omskcity/RF-transmitter/HW/RFMODEM-STACIONAR.xls

Revised: Friday, July 27, 2012
Revision: 1
Bill Of Materials July 27,2012 11:47:47 | Page1
Item | Quantity | Reference | Part
______________________________________________
1 | 2 | C1,C2 | 12pF NP0 0603 | Конденсатор SMD | Конденсатор SMD 12pF NP0 0603
2 | 12 | C3,C4,C6,C7,C8,C9,C10, | 0.1uF X7R 0603 | Конденсатор SMD | Конденсатор SMD 0.1uF X7R 0603
 |  | C11,C12,C13,C14,C23
3 | 2 | C20,C5 | 4.7uF 6.3V SMA | Конденсатор SMD | Конденсатор SMD 4.7uF 6.3V SMA
4 | 1 | C15 | 220pF NP0 0603 | Конденсатор SMD | Конденсатор SMD 220pF NP0 0603
5 | 1 | C16 | 0.01uF X7R 0603 | Конденсатор SMD | Конденсатор SMD 0.01uF X7R 0603
6 | 1 | C17 | 2.7pF NP0 0603 | Конденсатор SMD | Конденсатор SMD 2.7pF NP0 0603
7 | 1 | C18 | 68pF NP0 0603 | Конденсатор SMD | Конденсатор SMD 68pF NP0 0603
8 | 1 | C19 | 5.1pF NP0 0603 | Конденсатор SMD | Конденсатор SMD 5.1pF NP0 0603
9 | 1 | C21 | 1uF X7R 0603 | Конденсатор SMD | Конденсатор SMD 1uF X7R 0603
10 | 1 | DD1 | STM32F100CBT LQFP-48 | Микросхема | Микросхема STM32F100CBT LQFP-48
11 | 1 | D1 | BAT54C SOT23 | Диод | Диод BAT54C SOT23
12 | 1 | D2 | KPT-1608EC | Светодиод | Светодиод KPT-1608EC
13 | 1 | D3 | BZX84C15 SOT23 | Стабилитрон | Стабилитрон BZX84C15 SOT23
14 | 1 | D4 | KPT-1608SGC | Светодиод | Светодиод KPT-1608SGC
15 | 1 | JP1 | PLS-3 | Разъем | Разъем PLS-3
18 | 1 | L1 | LQW18ANR39J00D | Индуктивность | Индуктивность LQW18ANR39J00D
19 | 1 | L2 | MLG1608B33NJ | Индуктивность | Индуктивность MLG1608B33NJ
20 | 1 | L3 | MLG1608B47NJ | Индуктивность | Индуктивность MLG1608B47NJ
21 | 4 | R1,R2,R3,R4 | 100 5% 0603 | Резистор SMD | Резистор SMD 100 5% 0603
22 | 2 | R5,R6 | 0 5% 0603 | Резистор SMD | Резистор SMD 0 5% 0603
23 | 2 | R7,R9 | 1K 5% 0603 | Резистор SMD | Резистор SMD 1K 5% 0603
24 | 1 | U1 | MAX3222EEUP+ TSSOP20 | Микросхема | Микросхема MAX3222EEUP+ TSSOP20
25 | 1 | U2 | MRF49XA | Микросхема | Микросхема MRF49XA
26 | 1 | U5 | LT1117-3.3 SOT223 | Микросхема | Микросхема LT1117-3.3 SOT223
27 | 1 | X1 | 10MHz HC-49U/SM | Кв.резонатор SMD | Кв.резонатор SMD 10MHz HC-49U/SM
28 | 1 | Y1 | 8MHz HC-49U/SM | Кв.резонатор SMD | Кв.резонатор SMD 8MHz HC-49U/SM
