omskcity/RF-transmitter/HW/rfmodem-stacionar.dxf

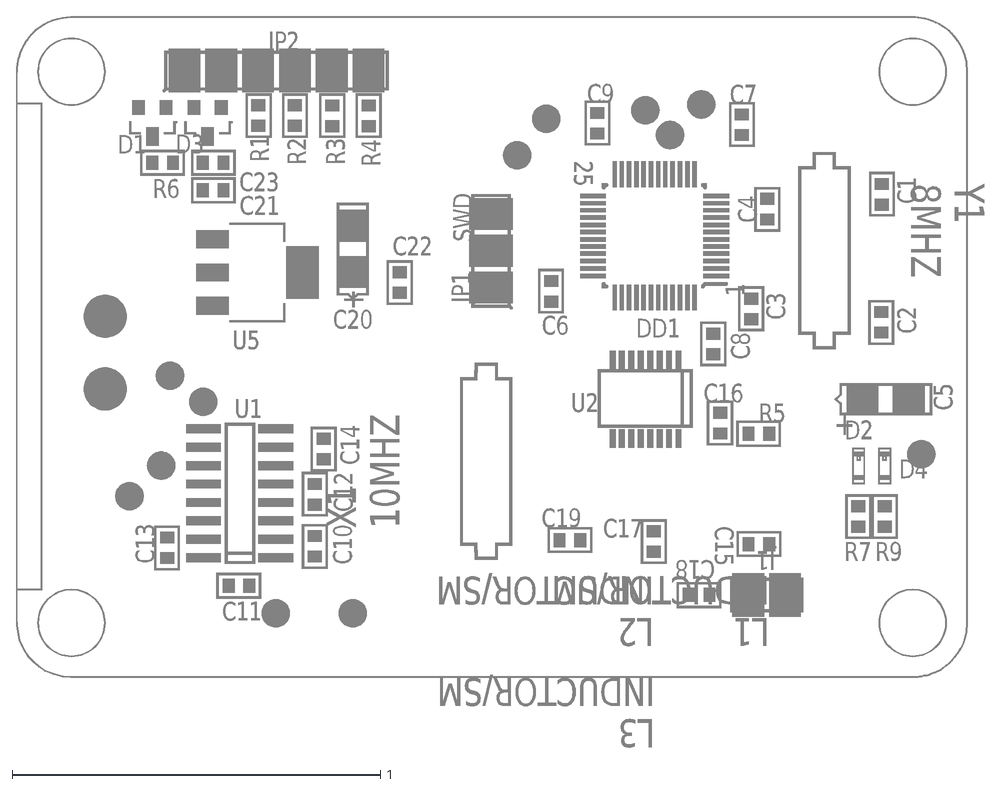
[picture p1: CAD file, 2012-10-08]
HW/rfmodem-stacionar.dxf
U2
INDUCTOR/SM
L3
C13
R9
C2
C23
C8
Y1
8MHZ
R6
C4
C9
C3
C5
+
C10
C21
JP2
U1
D2
DD1
25
1
C22
D1
R2
C20
C17
R3
R7
C18
C12
SWD
JP1
U5
R4
C19
J1
R5
C15
D3
C11
C6
C1
C14
C16
D4
R1
C7
L2
L1
X1
10MHZ
