omskcity/RF-transmitter/HW/Remote Top.pdf

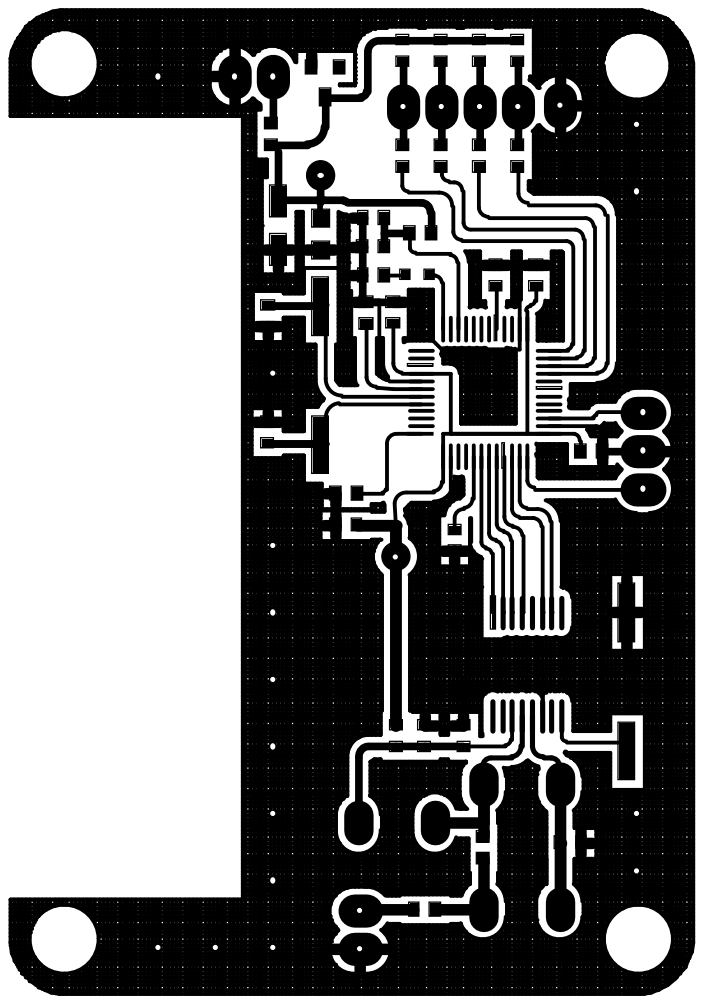
[picture p2: page 1]
