omskcity/RF-transmitter/HW/RFMODEM-STACIONAR-BOT.pdf

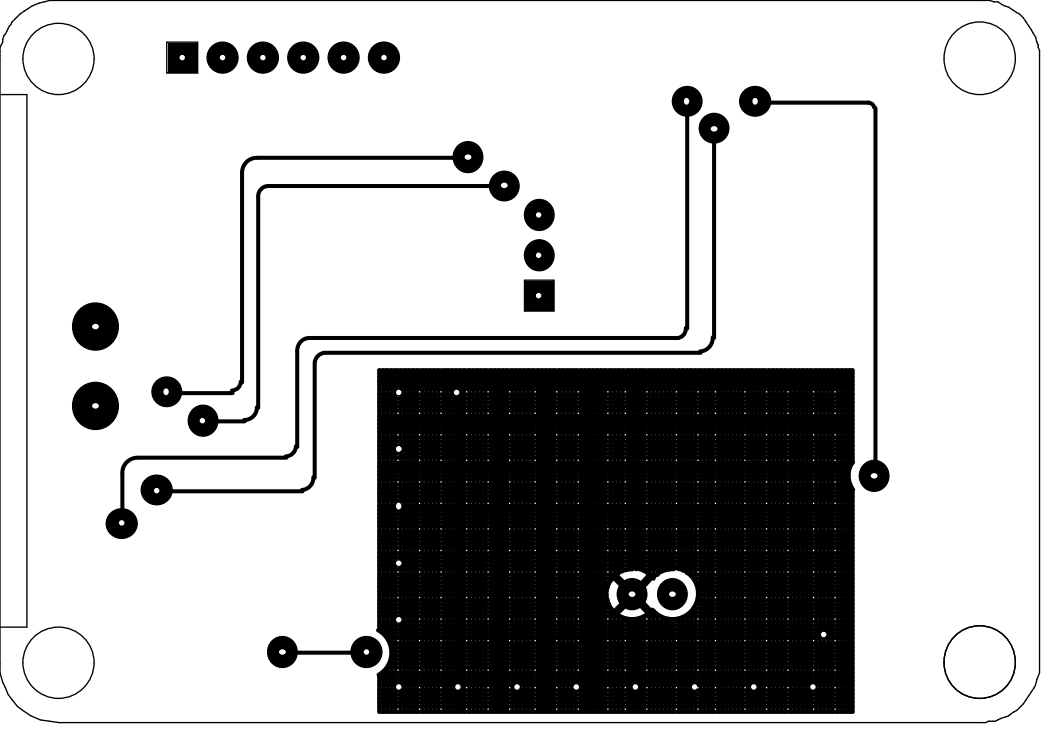
[picture p3: page 1]
