omskcity/RF-transmitter/HW/RFMODEM-STACIONAR-TOP.pdf

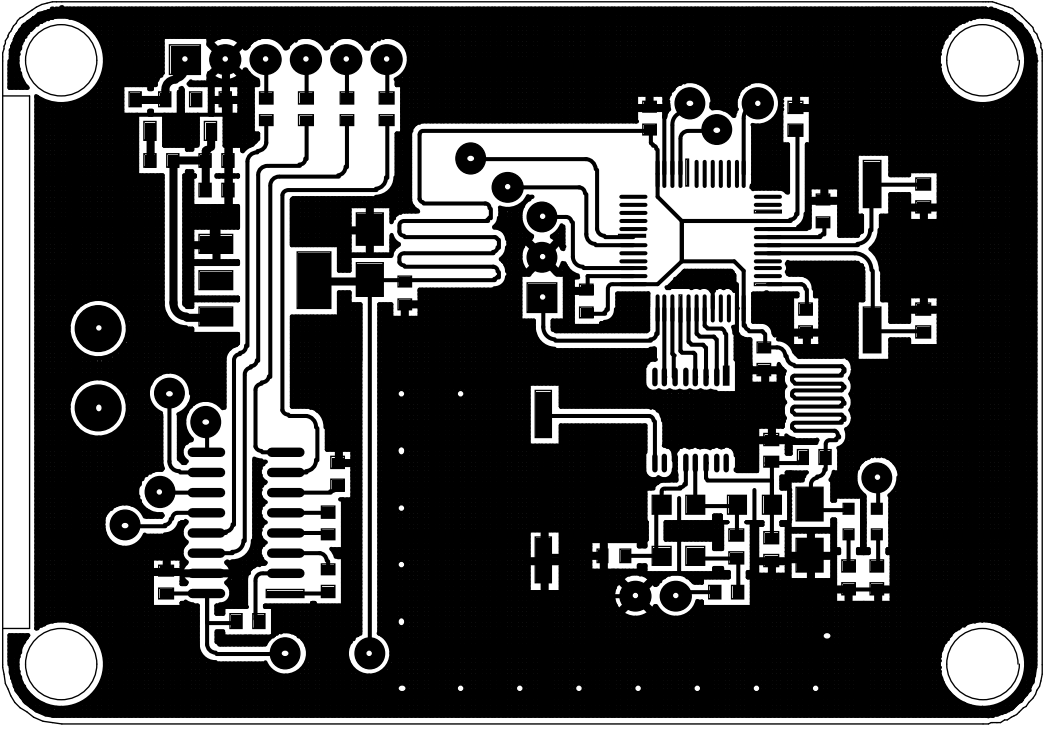
[picture p4: page 1]
