omskcity/RF-transmitter/HW/stacionar-cpu.pdf

# SWD 123

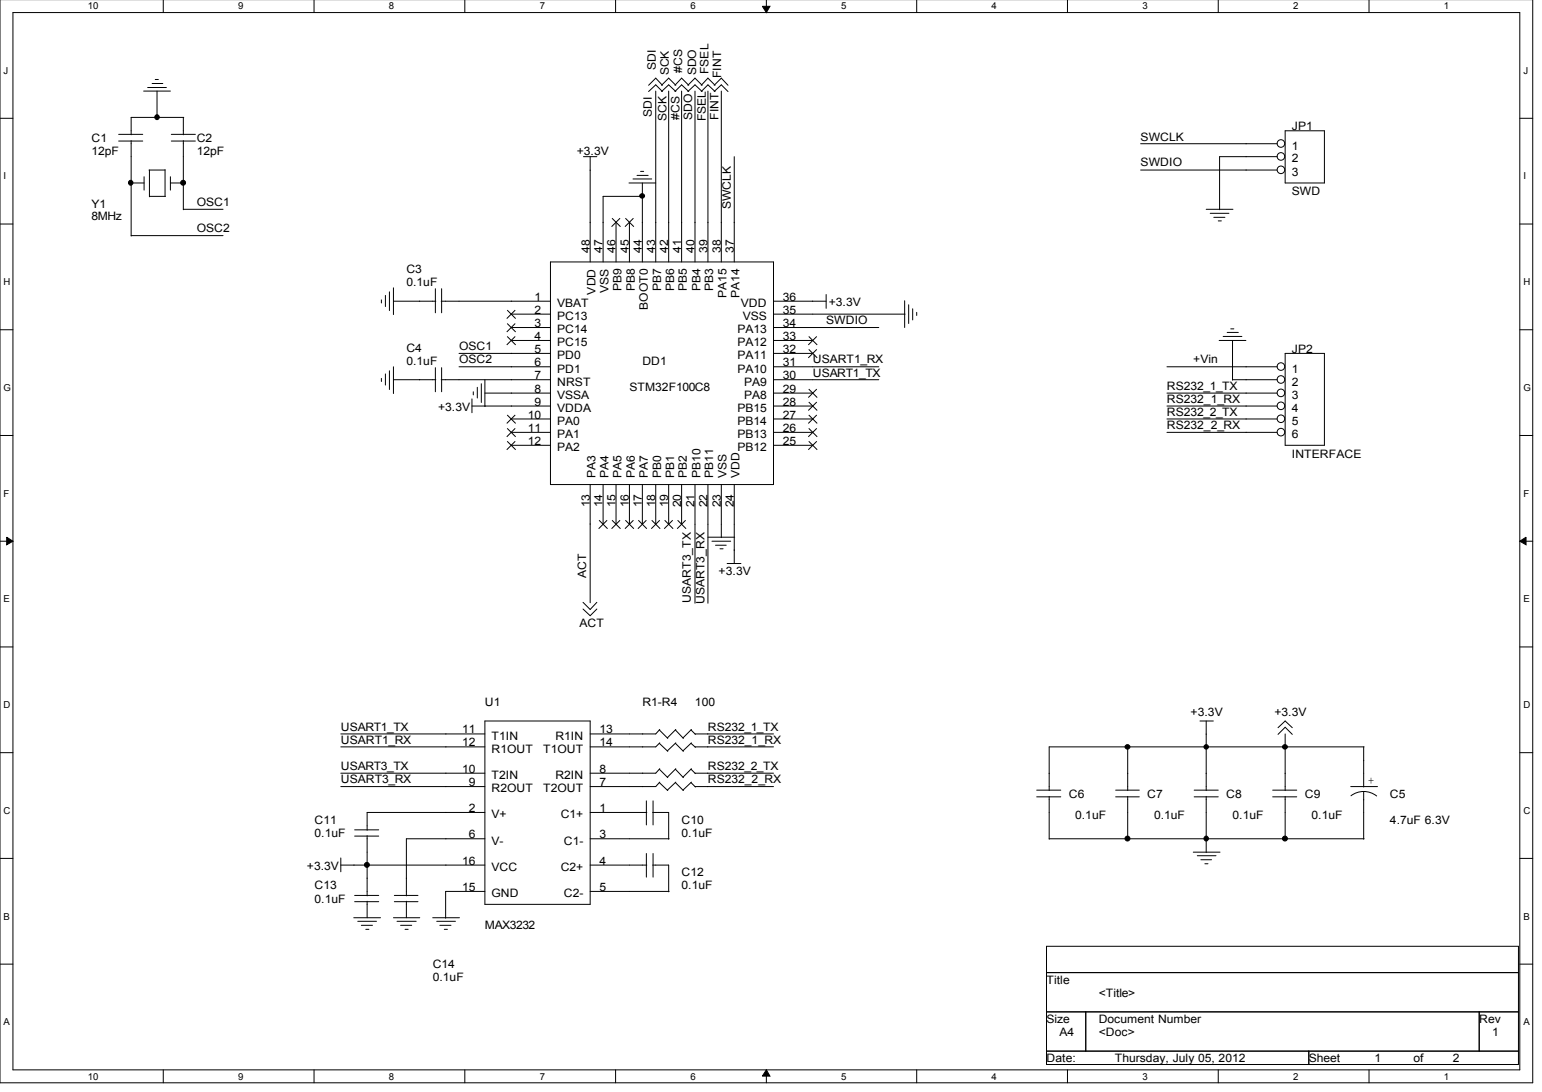
[picture p5: page 1]

Size A4 | Document Number <Doc> | Rev 1

Date: Thursday, July 05, 2012 | Sheet 1 of 2
