omskcity/RF-transmitter/HW/stacionar-rf.pdf

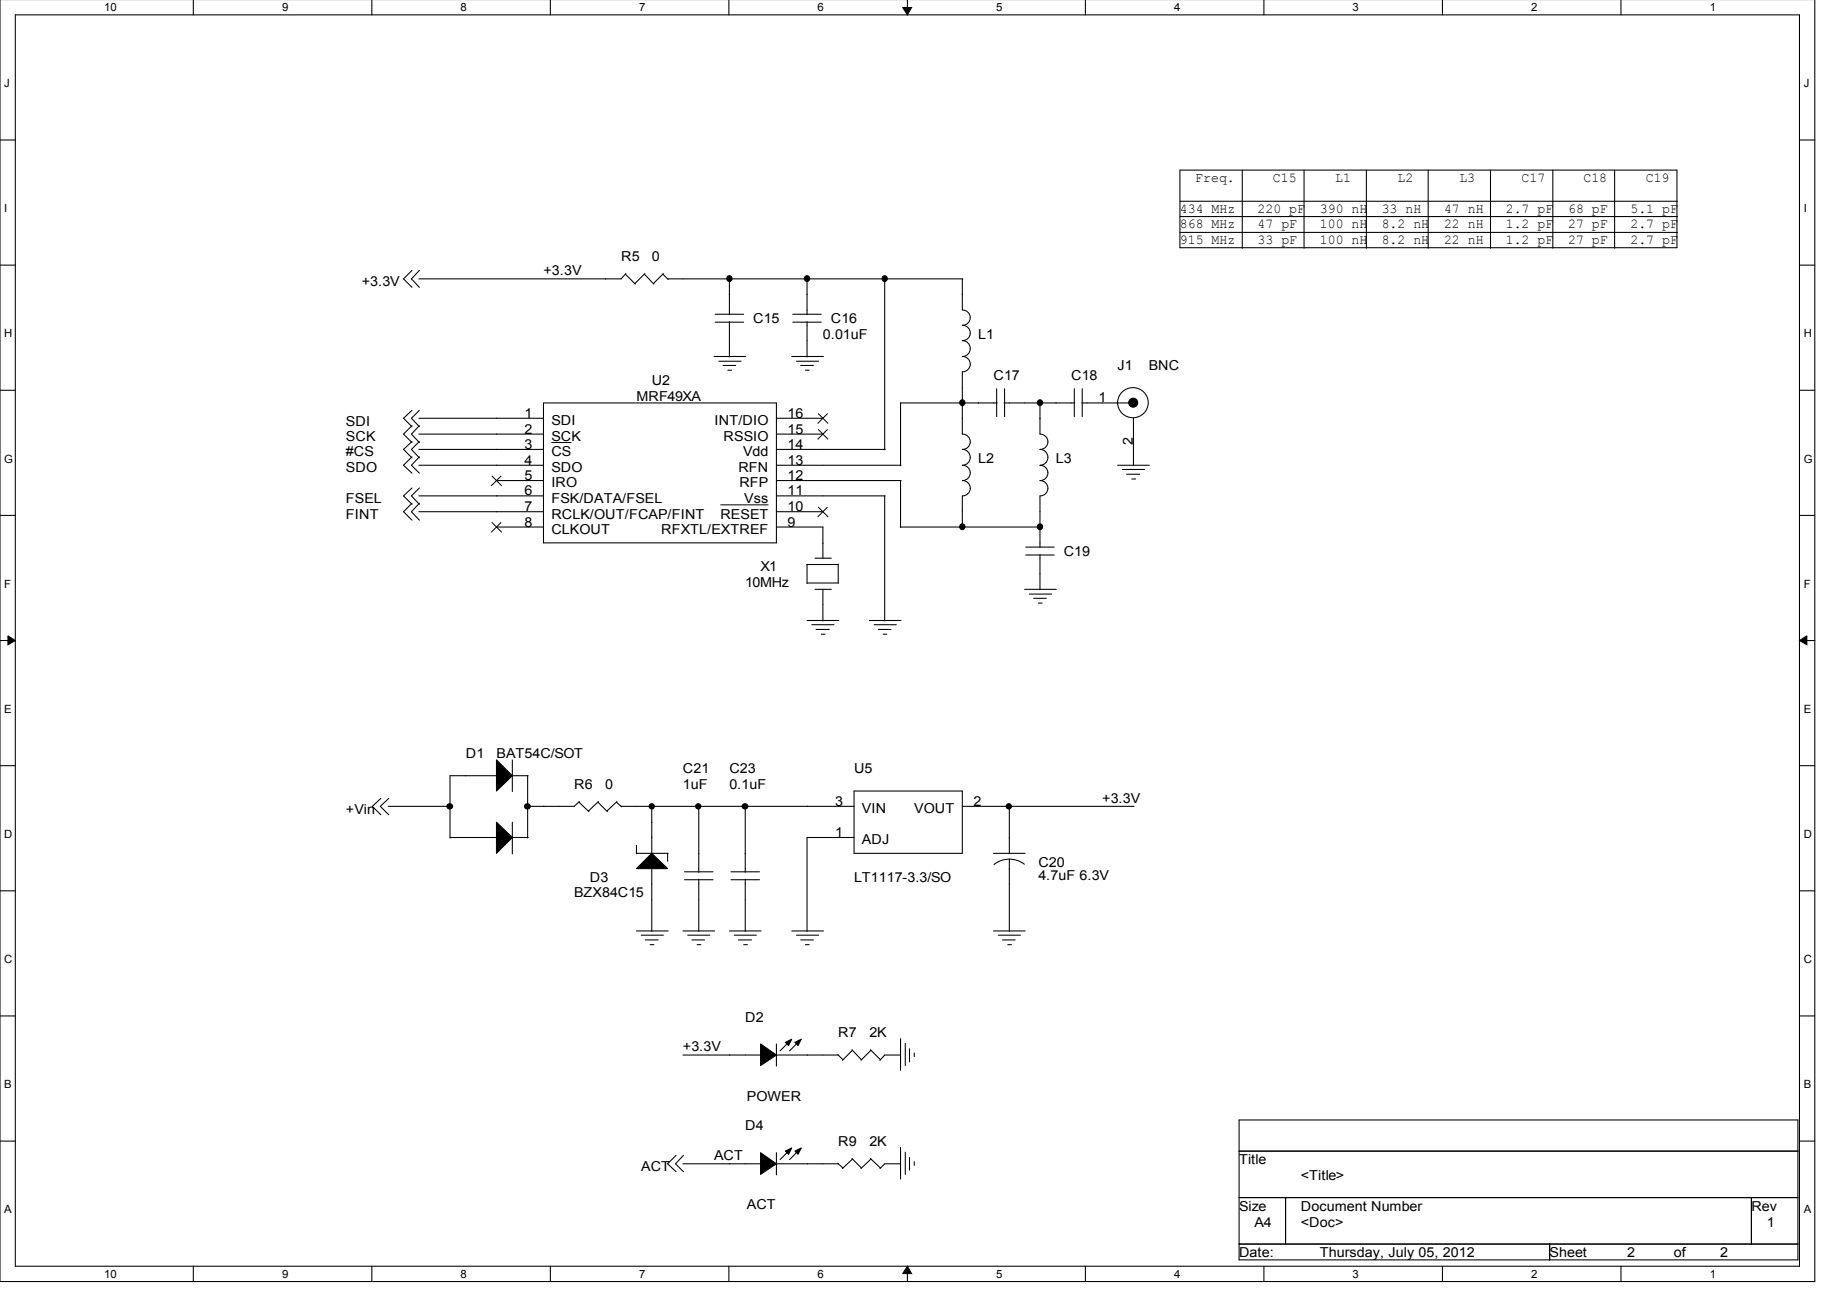
[picture p6: page 1]

Freq. | C15 | L1 | L2 | L3 | C17 | C18 | C19

434 MHz | 220 pF | 390 nH | 33 nH | 47 nH | 2.7 pF | 68 pF | 5.1 pF
868 MHz | 47 pF | 100 nH | 8.2 nH | 22 nH | 1.2 pF | 27 pF | 2.7 pF
915 MHz | 33 pF | 100 nH | 8.2 nH | 22 nH | 1.2 pF | 27 pF | 2.7 pF

Size A4 | Document Number <Doc> | Rev 1

Date: Thursday, July 05, 2012 | Sheet 2 of 2
