omskcity/RF-transmitter/(list of files, drawings)

Other design files:
HW/RFMODEM-STACIONAR.DSN
HW/RFMODEM-W-ORS232.DSN
HW/RFMODEM.DSN
HW/RFModem.opj
RFMODEM.DSN
