omskcity/RF-transmitter/(commit log)

2012-06-27 First push
    [RFMODEM.DSN, RFModem.opj]
2012-10-08 Вторая версия локальной части. Добавил батарейку для BakcupRAM.
    [RFMODEM-STACIONAR.DSN, RFMODEM-STACIONAR.xls, RFMODEM-W-ORS232.DSN, RFMODEM.DSN, rfmodem-stacionar.dxf]
2012-10-15 Последняя версия. Перехожу на поддержку нескольких устройств в одном локальном радиомодуле.
2012-11-06 Рабочий локальный модуль... Добавил описание его работы.
